Tejlilboy/Gripper/images/Gripper side view.png

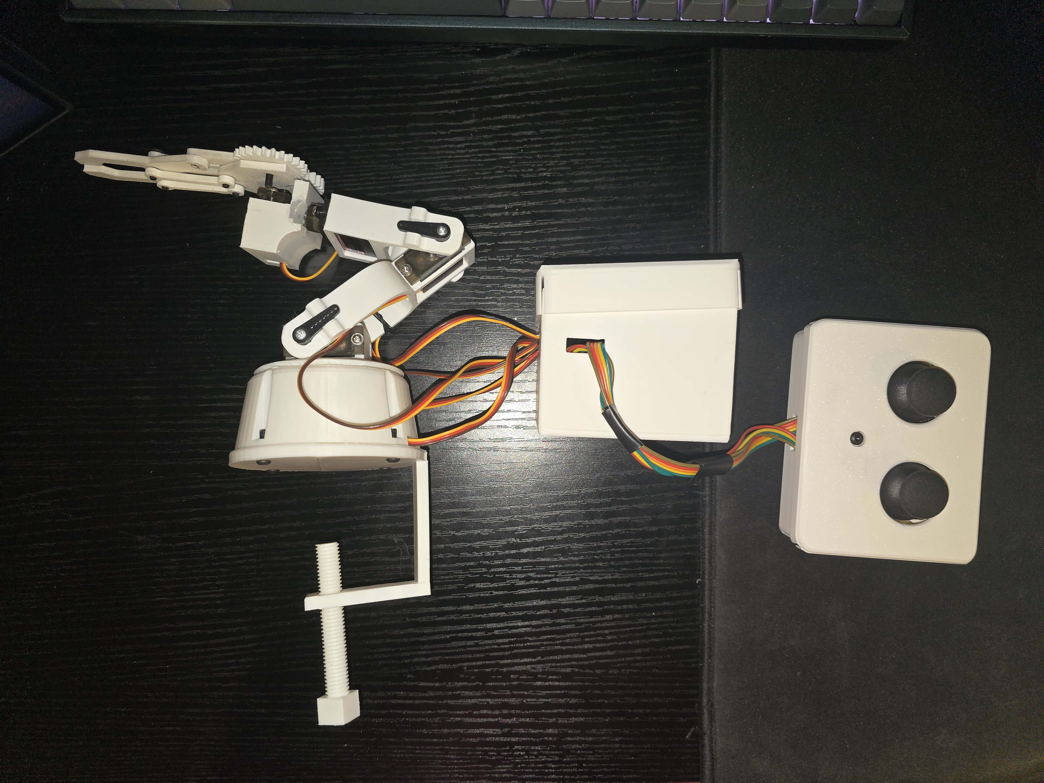
images/Gripper side view.png
