Tejlilboy/Gripper/stl-files/claw/Spur Gear main.stl

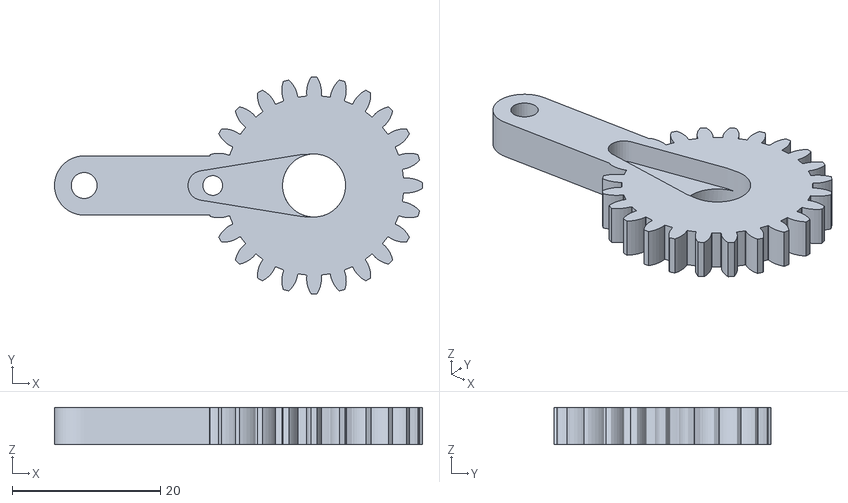
[picture p8: CAD file, 2026-10-10]
stl-files/claw/Spur Gear main.stl
49.6 x 29.2 x 5.00
