Tejlilboy/Gripper/stl-files/Arm/BaseArm.stl

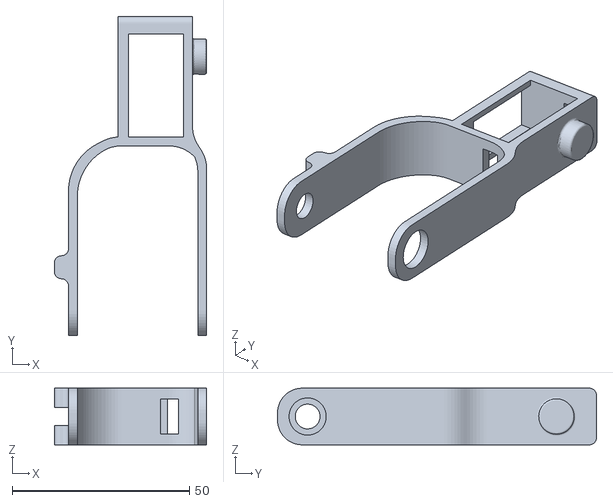
[picture p9: CAD file, 2026-10-10]
stl-files/Arm/BaseArm.stl
43.0 x 90.0 x 16.0
