Tejlilboy/Gripper/stl-files/Claw 1.stl

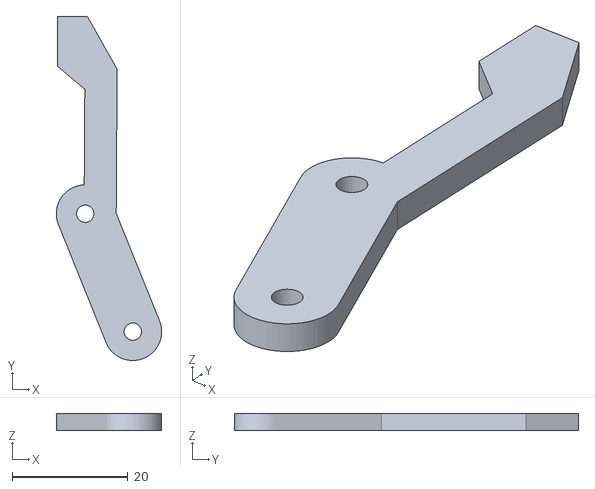
[picture p10: CAD file, 2026-10-10]
stl-files/Claw 1.stl
18.2 x 59.5 x 3.00
