Tejlilboy/Gripper/stl-files/PCB case/Arm case.3mf

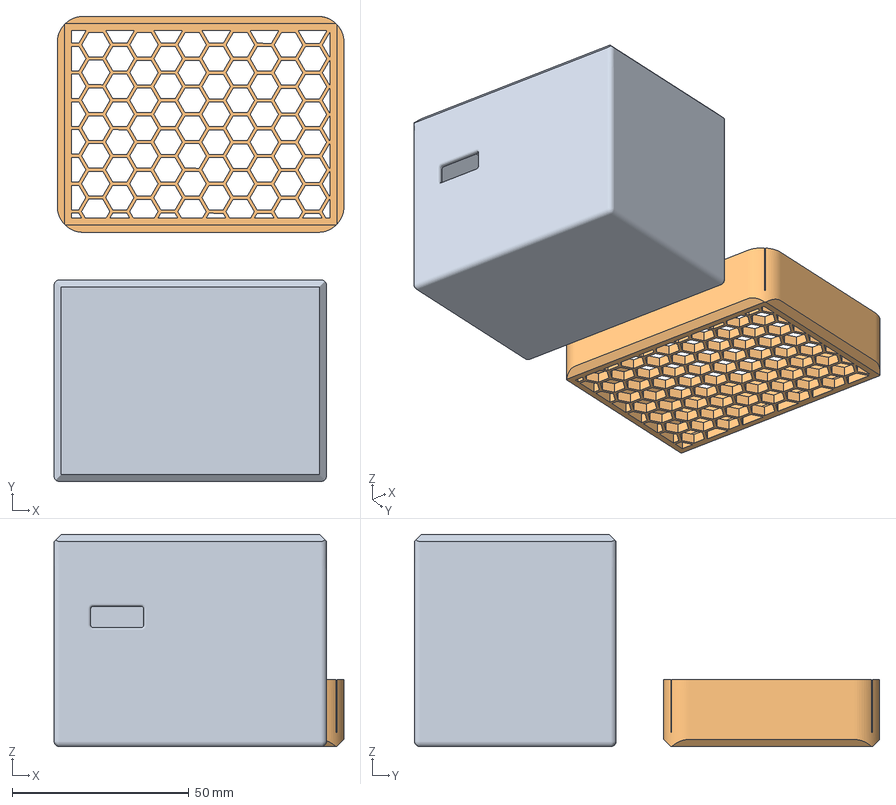
[picture p11: CAD file, 2026-10-10]
stl-files/PCB case/Arm case.3mf
81.9 x 131.4 x 60.0 mm
Arm case.stl
cap.stl
