Tejlilboy/Gripper/stl-files/Arm/MidArm.stl

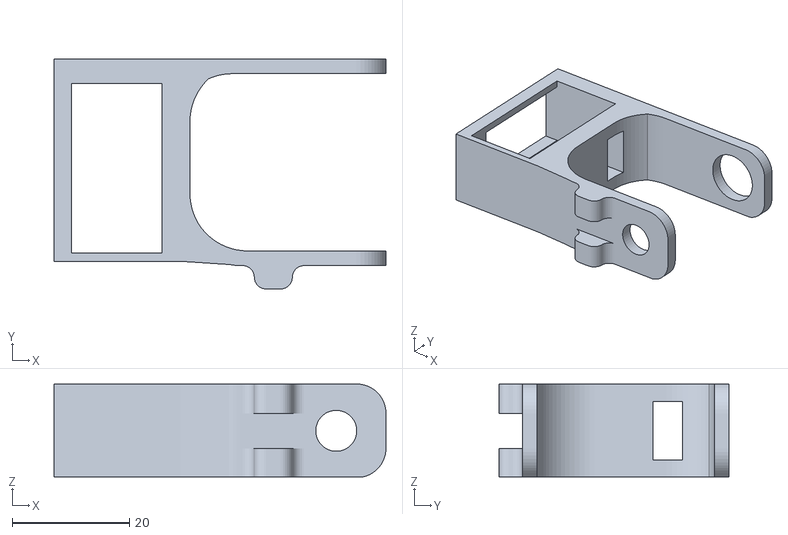
[picture p12: CAD file, 2026-10-10]
stl-files/Arm/MidArm.stl
56.7 x 39.3 x 15.9
