Tejlilboy/Gripper/stl-files/claw/Spur Gear 2.stl

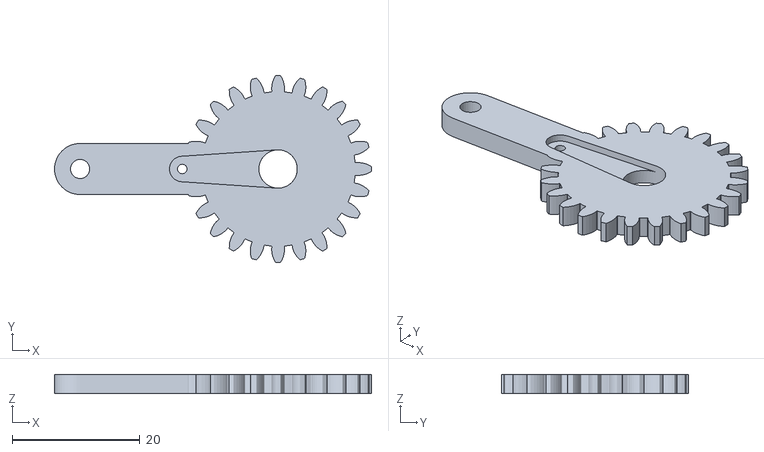
[picture p13: CAD file, 2026-10-10]
stl-files/claw/Spur Gear 2.stl
49.6 x 29.2 x 3.00
