Tejlilboy/Gripper/stl-files/controller bottom.stl

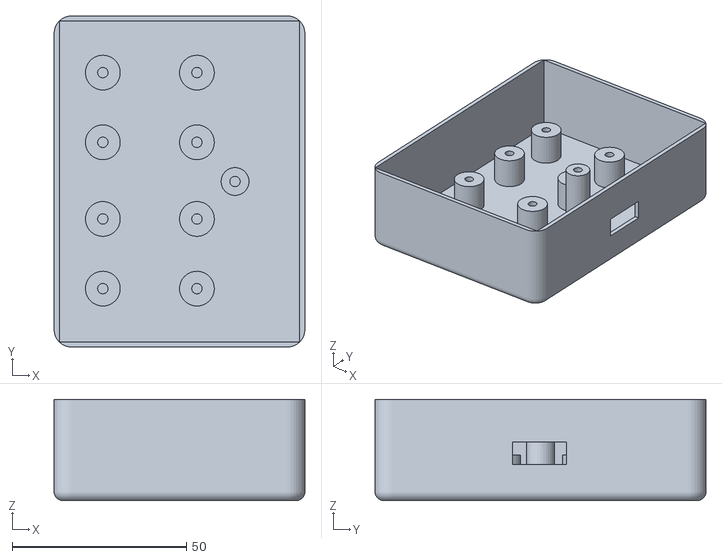
[picture p14: CAD file, 2026-10-02]
stl-files/controller bottom.stl
72.0 x 95.0 x 29.0
