Tejlilboy/Gripper/stl-files/controller cap.stl

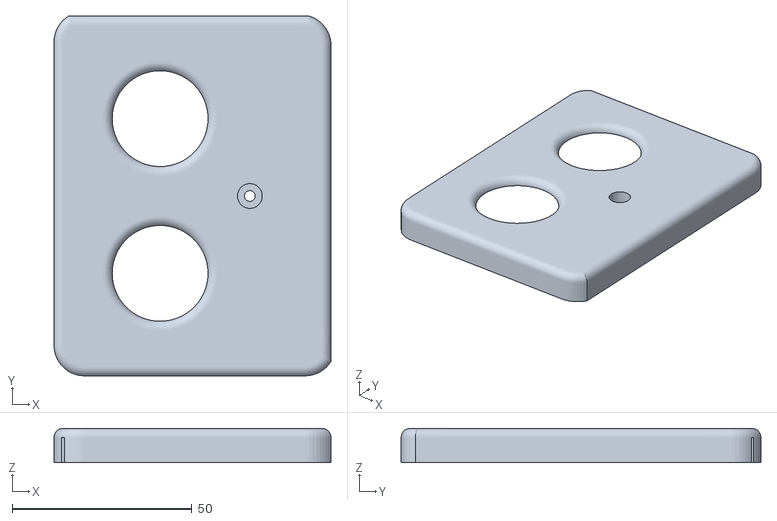
[picture p15: CAD file, 2026-10-02]
stl-files/controller cap.stl
77.0 x 100.0 x 9.50
