Tejlilboy/Gripper/(list of files, cad)

Other CAD files:
stl-files/claw/Claw 2.stl
