Tejlilboy/Gripper/(commit log)

2026-10-02 joystick housing
    [controller bottom.stl, controller cap.stl]
2026-10-02 Added new files
    [controller bottom.stl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]
2026-10-10 Additional stl files
