Tejlilboy/Gripper/images/Gripper board soldered.png

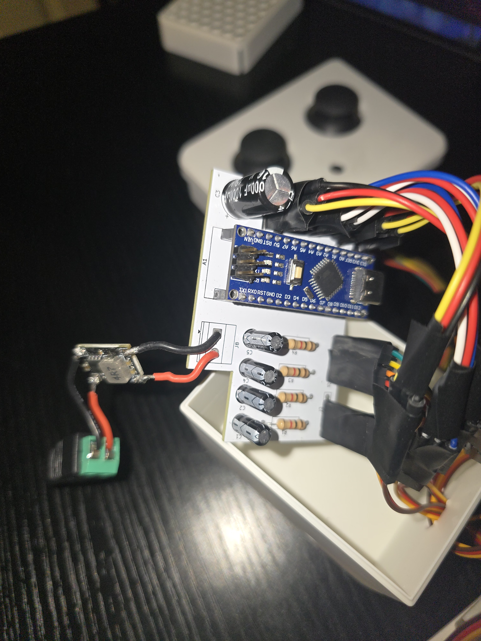
[picture p6: images/Gripper board soldered.png]
images/Gripper board soldered.png
